erescob/SparkX_AI-SED2026_Entrega/SparkX_AI-SED2026_Entrega/02_Hardware_PCB/SISTEMA_PCB.manifest.md

# Output Job Manifest
**Profile:** AI_PLACEMENT_REVIEW
**Date:** 2026-11-05T23:32:19

## PDF Image
- PDF Image.pdf

## Bill of Materials
- Bill of Materials.csv

## Schematic PDF
- Schematic PDF.pdf

## Pick and Place
- Pick and Place.csv
