erescob/SparkX_AI-SED2026_Entrega/SparkX_AI-SED2026_Entrega/05_Simulacion_Proteus/proteus_banco_cableado.png

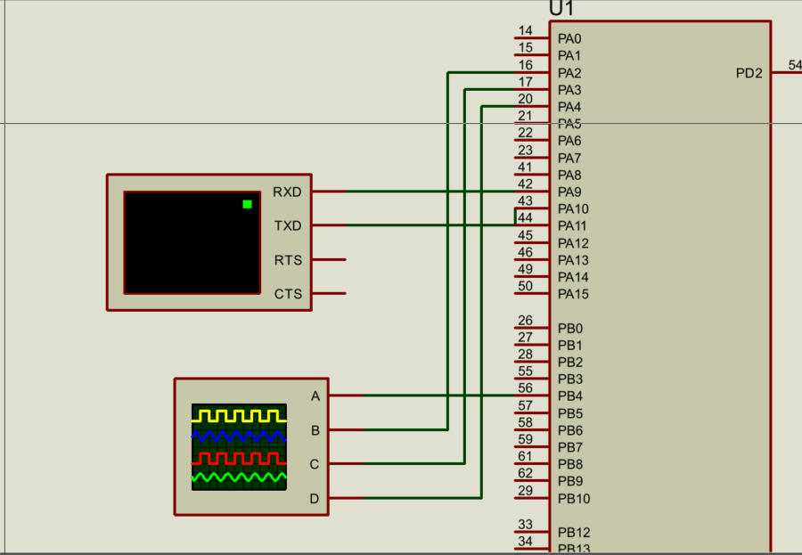
SparkX_AI-SED2026_Entrega/05_Simulacion_Proteus/proteus_banco_cableado.png
