erescob/SparkX_AI-SED2026_Entrega/SparkX_AI-SED2026_Entrega/03_Codigo_fuente/resultados/figuras/importancia_rocio.png

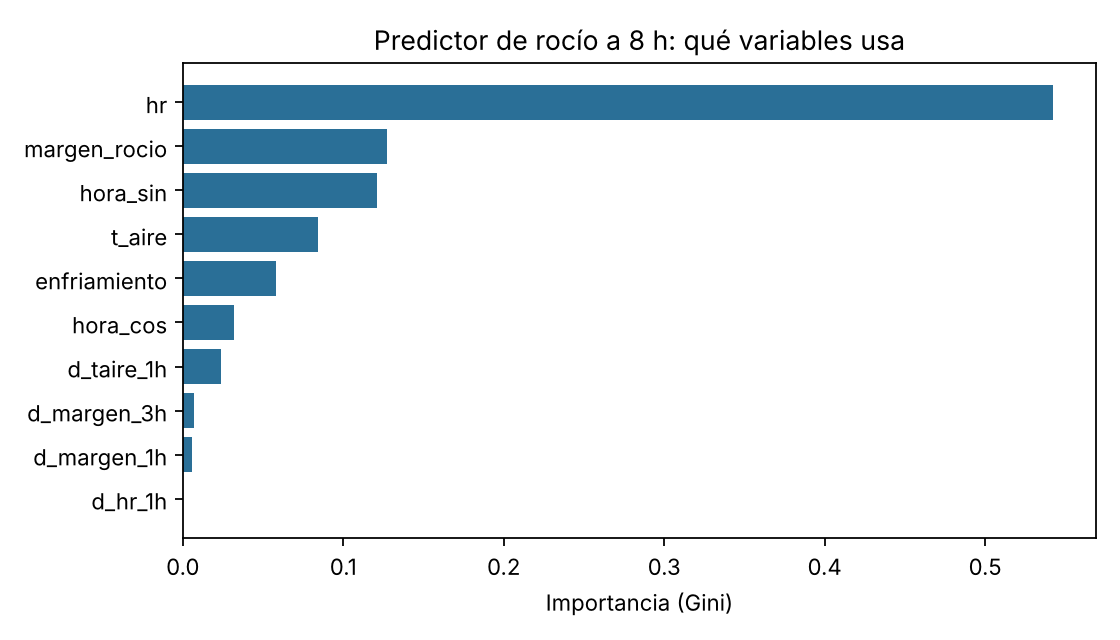
SparkX_AI-SED2026_Entrega/03_Codigo_fuente/resultados/figuras/importancia_rocio.png
