erescob/SparkX_AI-SED2026_Entrega/SparkX_AI-SED2026_Entrega/03_Codigo_fuente/resultados/figuras/red_28dias.png

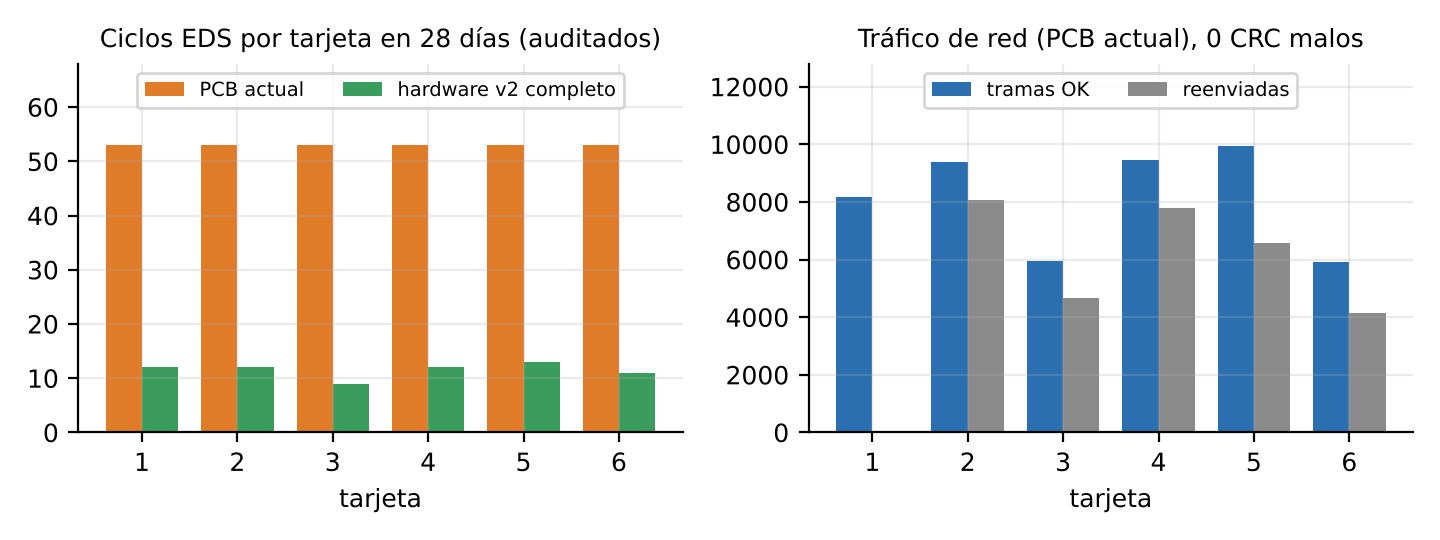
SparkX_AI-SED2026_Entrega/03_Codigo_fuente/resultados/figuras/red_28dias.png
