erescob/SparkX_AI-SED2026_Entrega/SparkX_AI-SED2026_Entrega/03_Codigo_fuente/resultados/figuras/seguridad_alertas.png

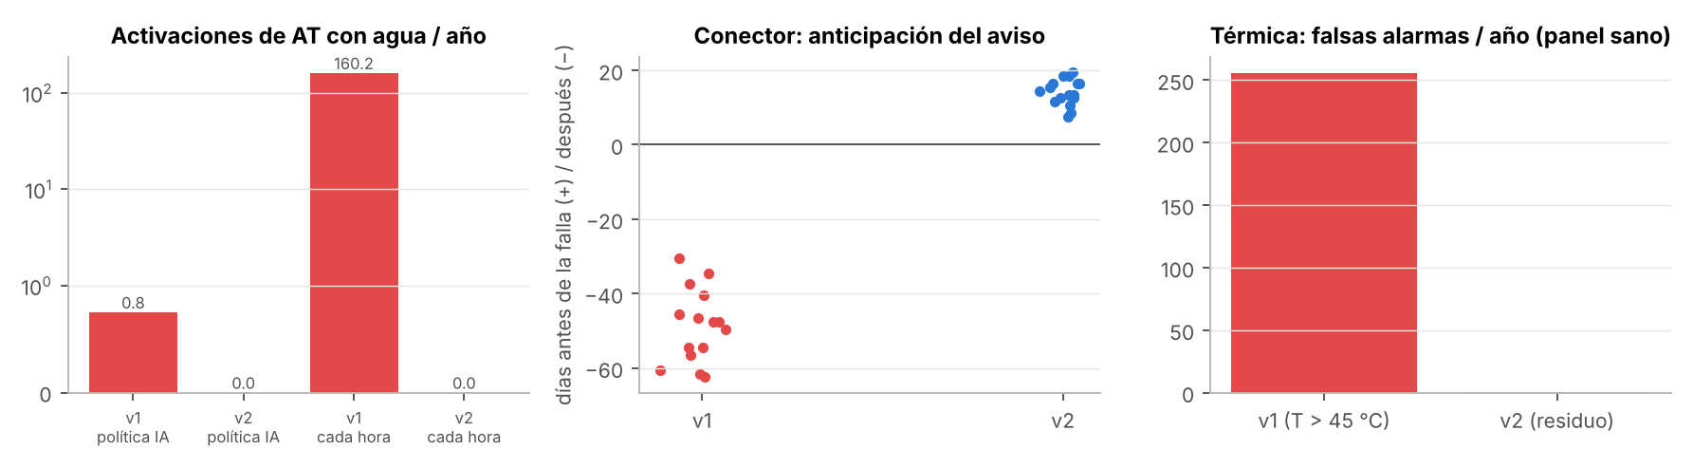
SparkX_AI-SED2026_Entrega/03_Codigo_fuente/resultados/figuras/seguridad_alertas.png
