erescob/SparkX_AI-SED2026_Entrega/SparkX_AI-SED2026_Entrega/02_Hardware_PCB/Schematic PDF.pdf

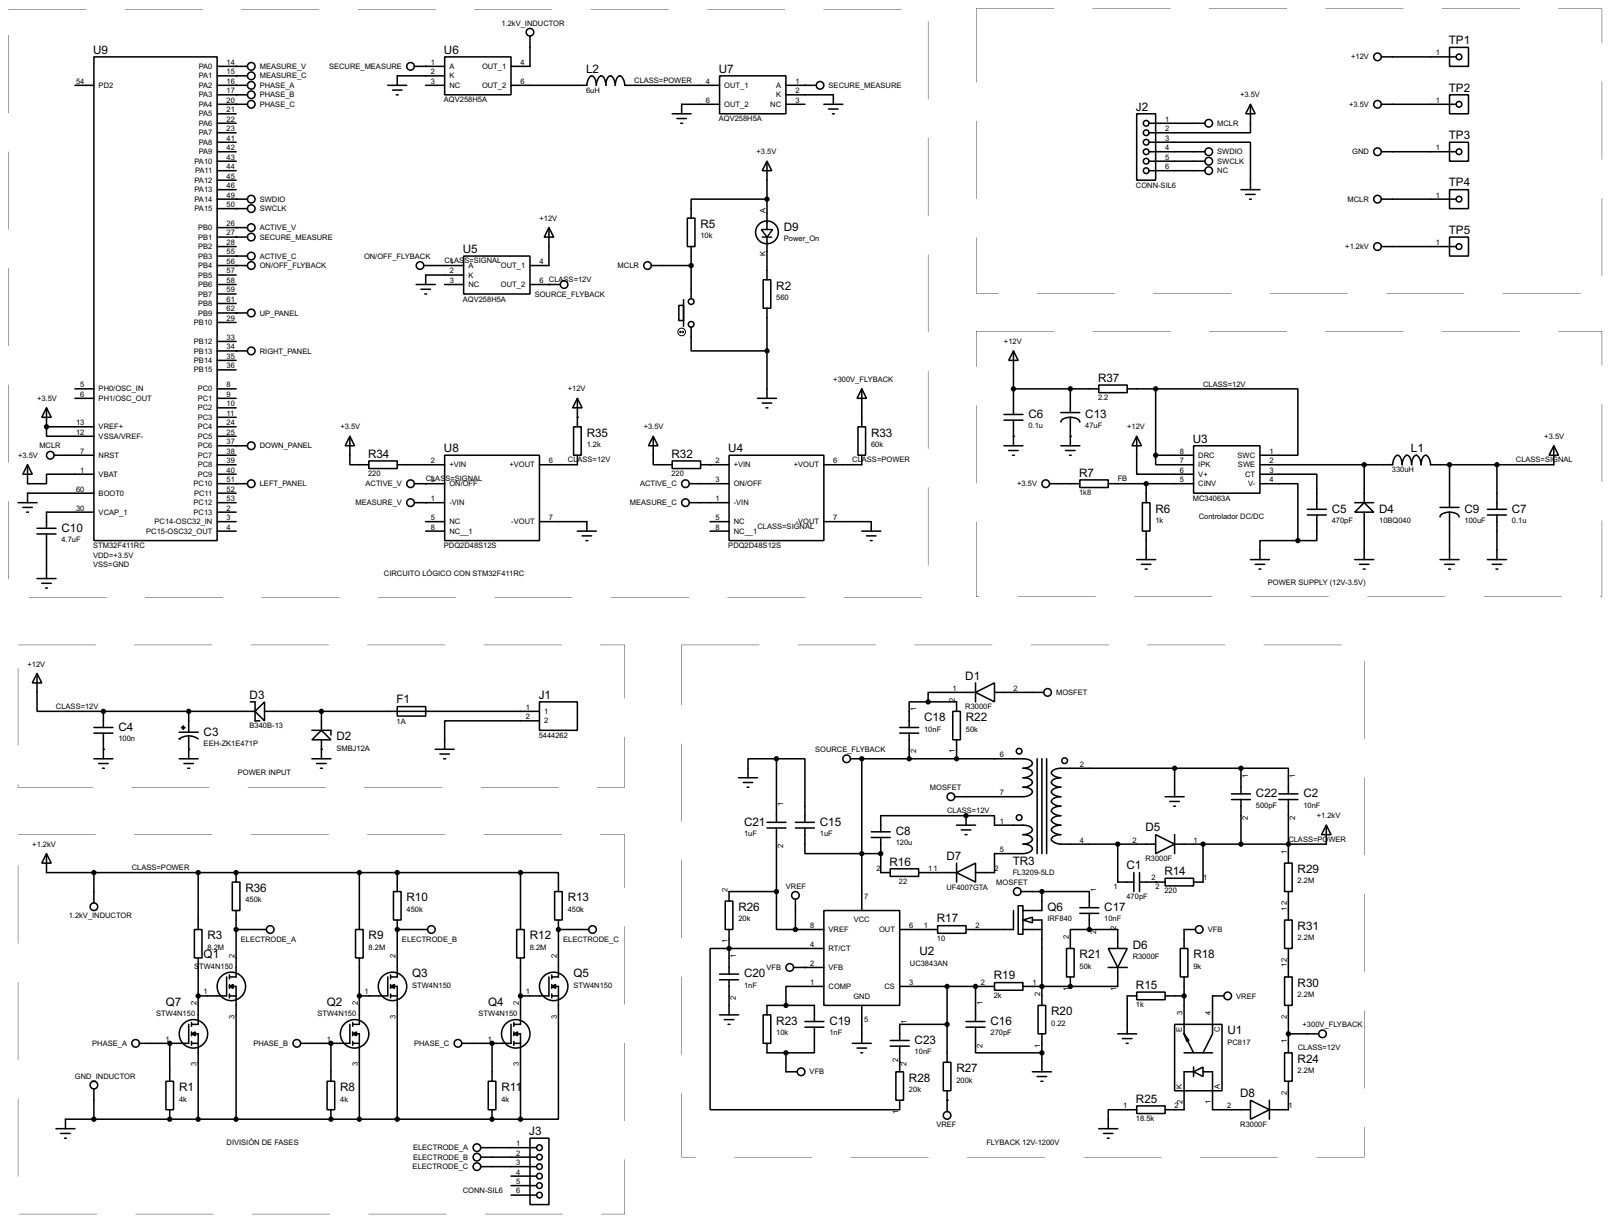
[picture p48: page 1]

CLASS=SIGNAL CLASS=12V CLASS=SIGNAL
+VIN
