erescob/SparkX_AI-SED2026_Entrega/SparkX_AI-SED2026_Entrega/02_Hardware_PCB/PDF Image.pdf

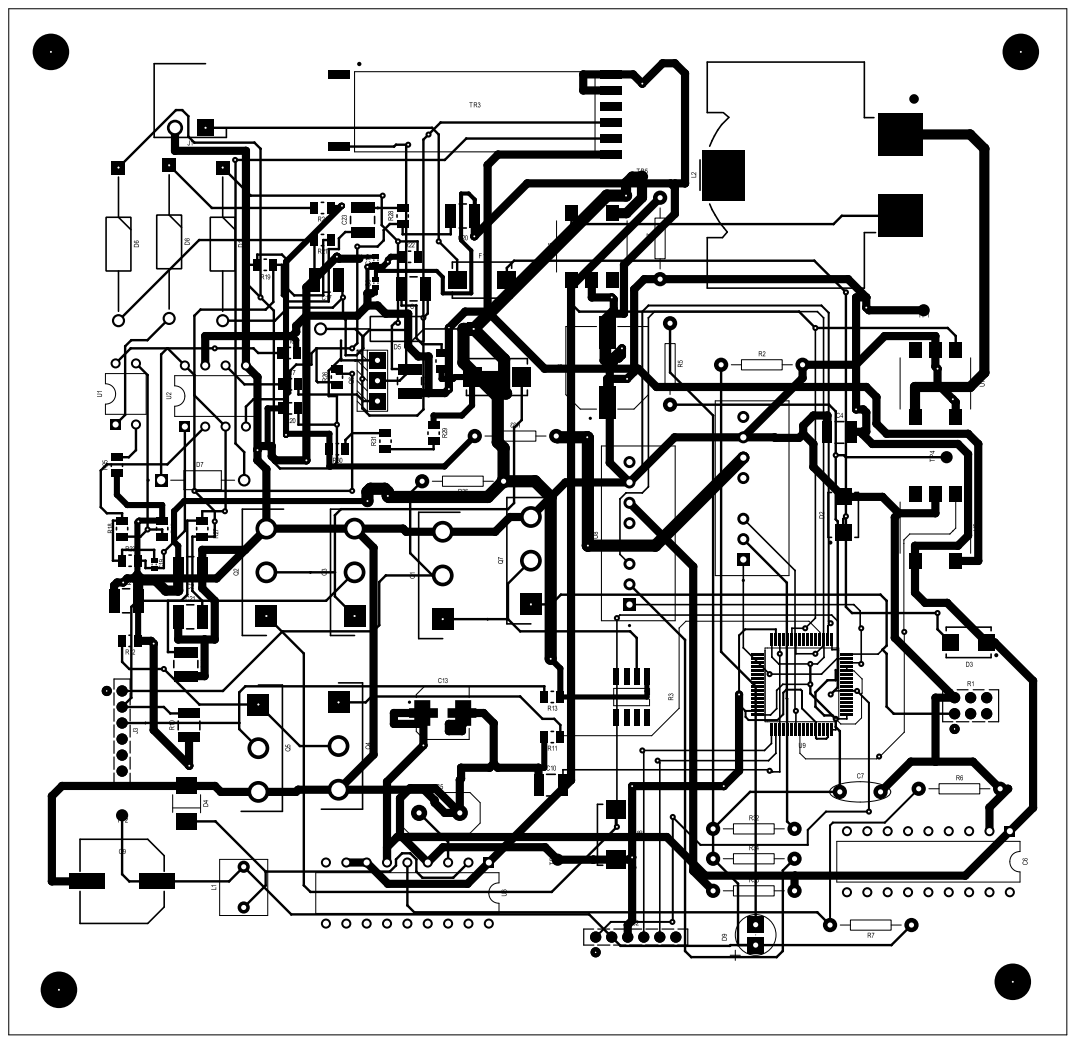
[picture p49: page 1]
