erescob/SparkX_AI-SED2026_Entrega/SparkX_AI-SED2026_Entrega/03_Codigo_fuente/firmware/sx_demo_datos.h

/* sx_demo_datos.h — GENERADO por python/generar_red_demo.py (NO editar a mano)
 * Lecturas simuladas para el MODO DEMO (Proteus sin sensores reales).
 * Tabla A: tarjeta sana.  Tabla B: tarjeta con conector degradándose (día 9) y punto caliente (día 14). */
#ifndef SX_DEMO_DATOS_H
#define SX_DEMO_DATOS_H
#include <stdint.h>
#define SX_DEMO_PASOS 2688
/* SX_DEMO_A: 2688 pasos de 15 min. Escalas: t*100, hr*100, isc*100 (mA), c*10 (nF), g*1000 (uS) */
static const int16_t SX_DEMO_A[2688][7] = {
{1330,4743,1118,0,0,1007,21},
{1315,4723,1084,0,0,1006,21},
{1352,4750,998,0,0,1004,32},
{1316,4856,986,0,0,1011,21},
{1269,4808,1006,0,0,1003,25},
{1239,4811,1072,0,0,999,24},
{1269,4700,980,0,0,1005,23},
{1250,4774,962,0,0,1003,23},
{1230,4946,976,0,0,1006,23},
{1204,5049,970,0,0,1010,23},
{1190,4963,839,0,0,999,22},
{1164,4888,873,0,0,1002,23},
{1177,4959,857,0,0,1005,26},
{1146,5185,788,0,0,1000,22},
{1124,5042,757,0,0,1003,25},
{1143,5083,733,0,0,1006,29},
{1087,5190,781,0,0,1001,22},
{1095,5194,774,0,0,1003,30},
{1076,5336,676,0,0,1003,20},
{1094,4948,693,0,0,1003,20},
{1048,5219,643,0,0,1004,22},
{1036,5412,666,0,0,1006,24},
{1026,5373,674,0,0,1003,23},
{1063,5491,727,0,0,1002,21},
{991,5368,646,0,0,1000,23},
{1031,5467,691,0,0,1005,24},
{981,5645,636,0,0,1001,24},
{996,5489,691,0,0,1001,20},
{1008,5602,715,0,0,1000,25},
{1027,5718,635,0,0,1002,25},
{1030,5599,733,15,15,1006,23},
{1095,5729,746,120,120,1003,27},
{1103,5465,999,292,292,1000,22},
{1159,5215,1241,581,580,1007,24},
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
{13492,13324,983},
{13539,13355,985},
{13411,13183,986},
{13556,13292,980},
{13484,13195,989},
{13475,13080,984},
{13487,13006,992},
{13044,12464,986},
{13539,12893,989},
{13508,12520,979},
{13409,12124,985},
};
#define SX_DEMO_B_C_REF 99.307374f
#define SX_DEMO_B_K_SR  0.999554f
#endif
